sk3tch/rfid-emulator/README

This is the RFID emulator demoed at Defcon 18.  See the PDF for details.
